cliffanet/rwled/hw/ctrl/rwled-ctrl-v0.1.png

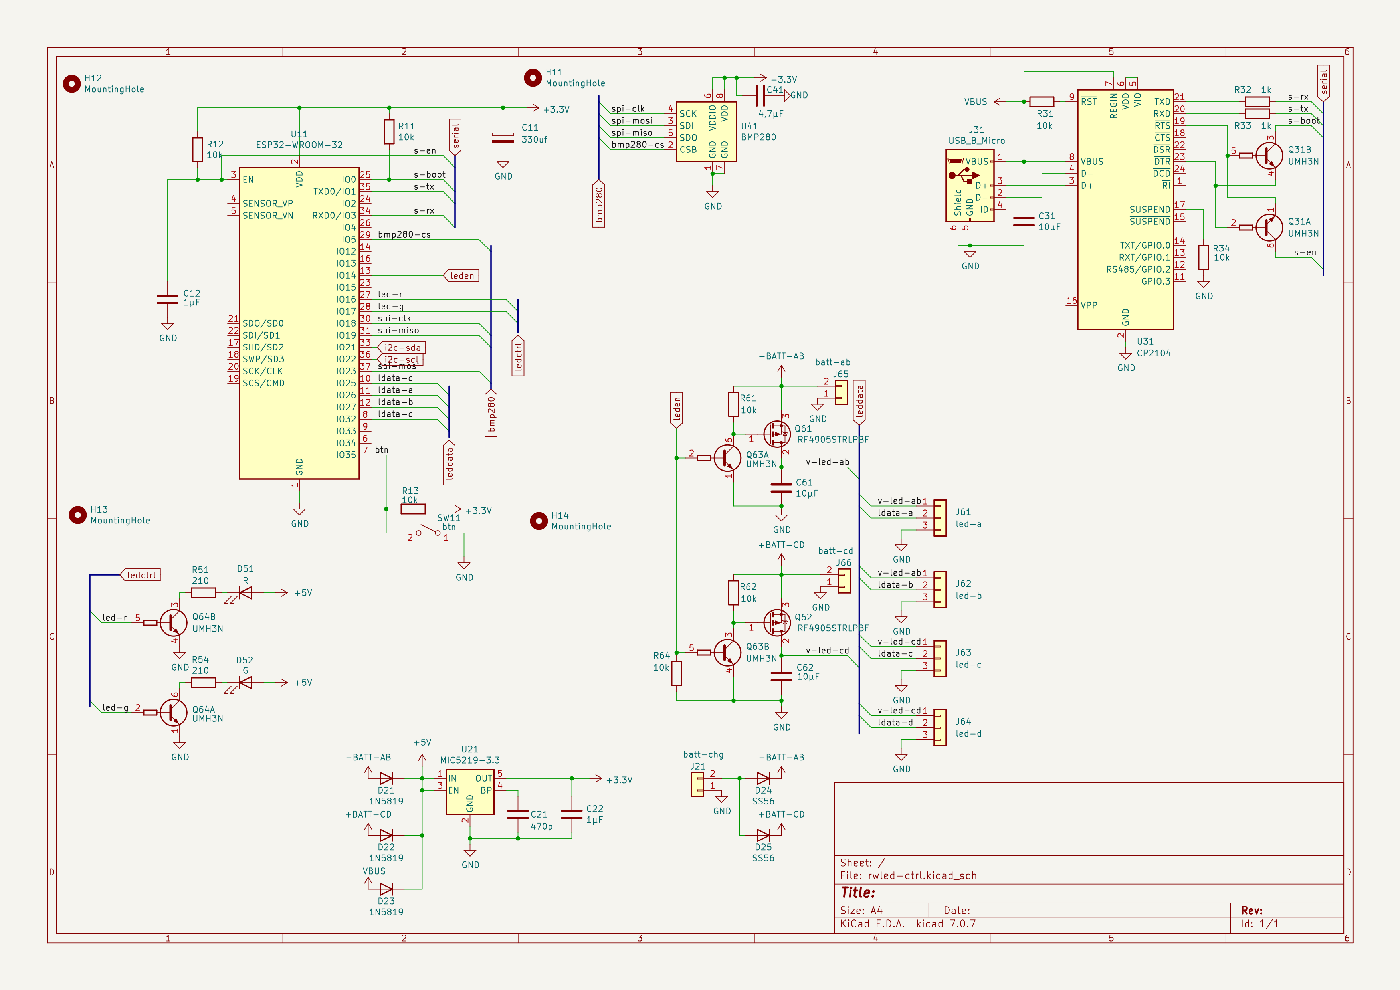
hw/ctrl/rwled-ctrl-v0.1.png
