cliffanet/rwled/hw/ctrl/rwled-ctrl-v0.2.png

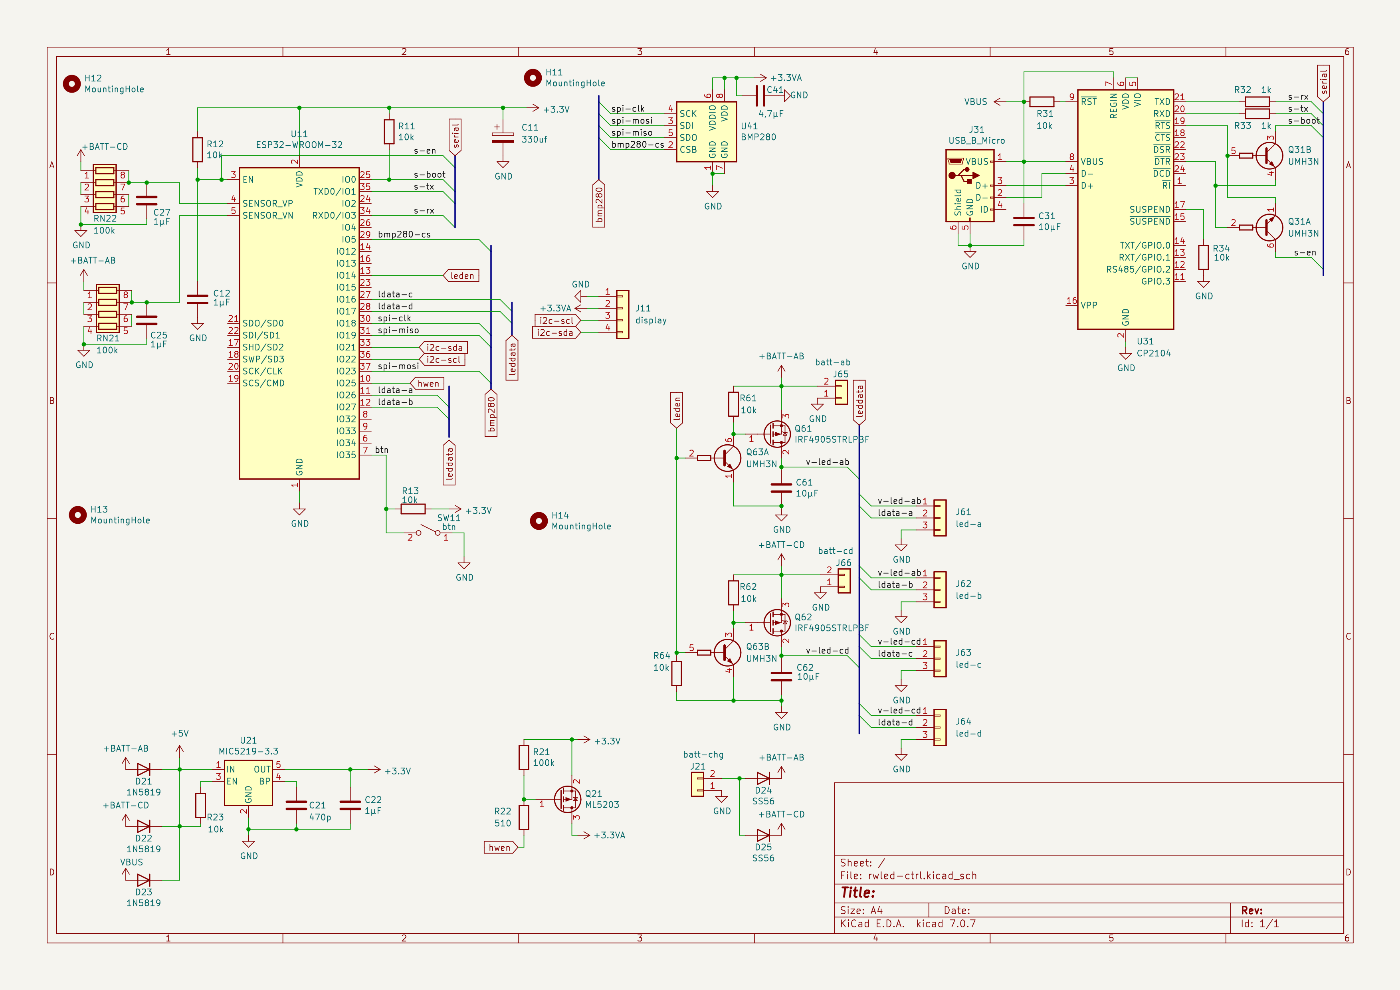
hw/ctrl/rwled-ctrl-v0.2.png
