cliffanet/rwled/hw/ledpanel-al10/v0.2/ledpanel-al10-v0.1.png

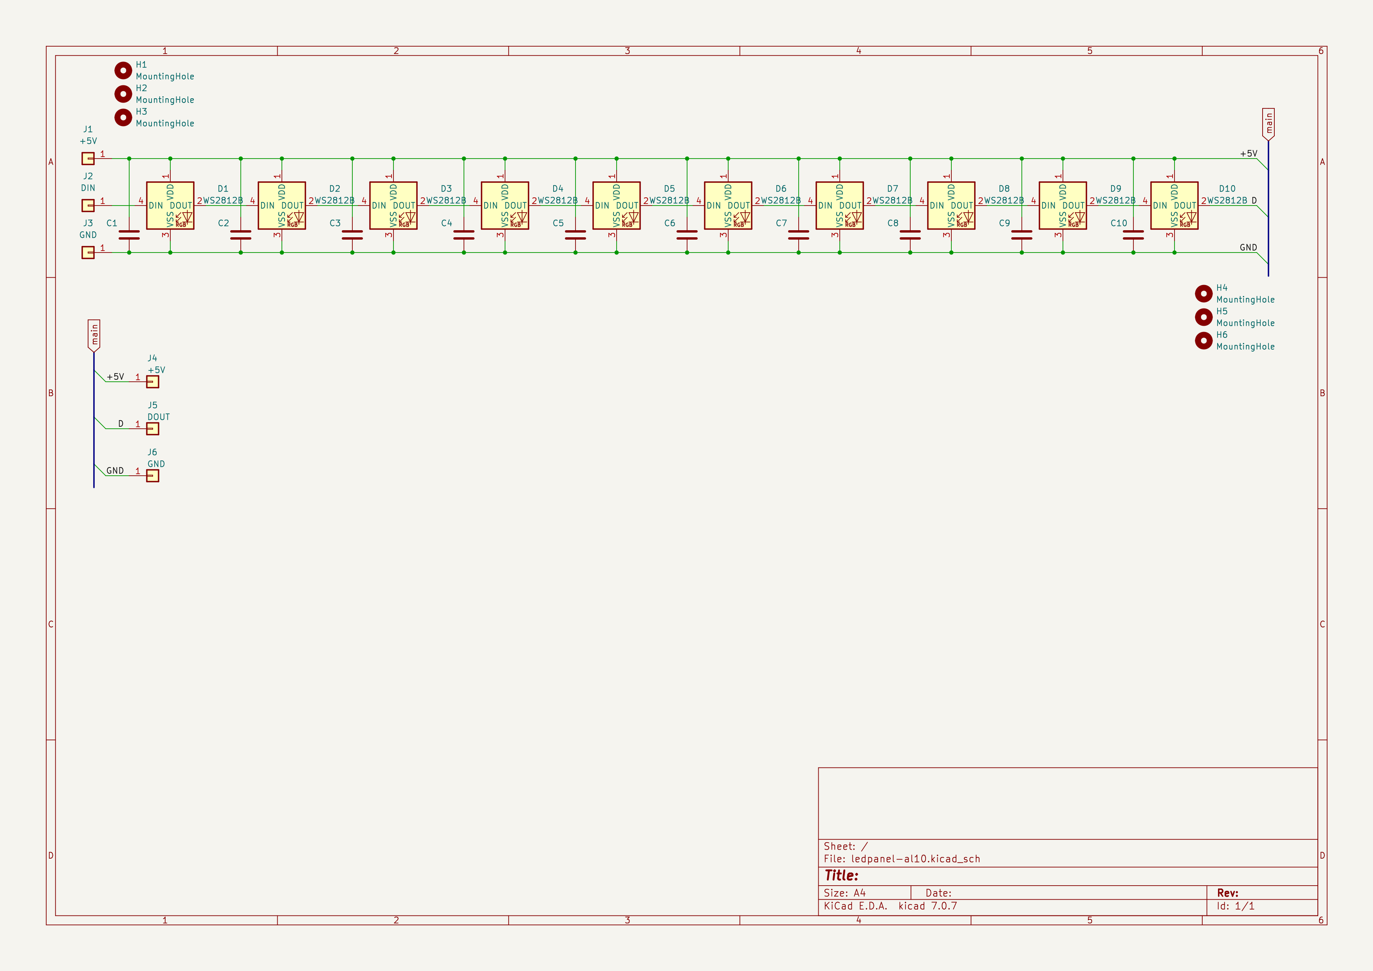
hw/ledpanel-al10/v0.2/ledpanel-al10-v0.1.png
