cliffanet/rwled/hw/ledpanel-al20/v0.2/ledpanel-al20-v0.1.png

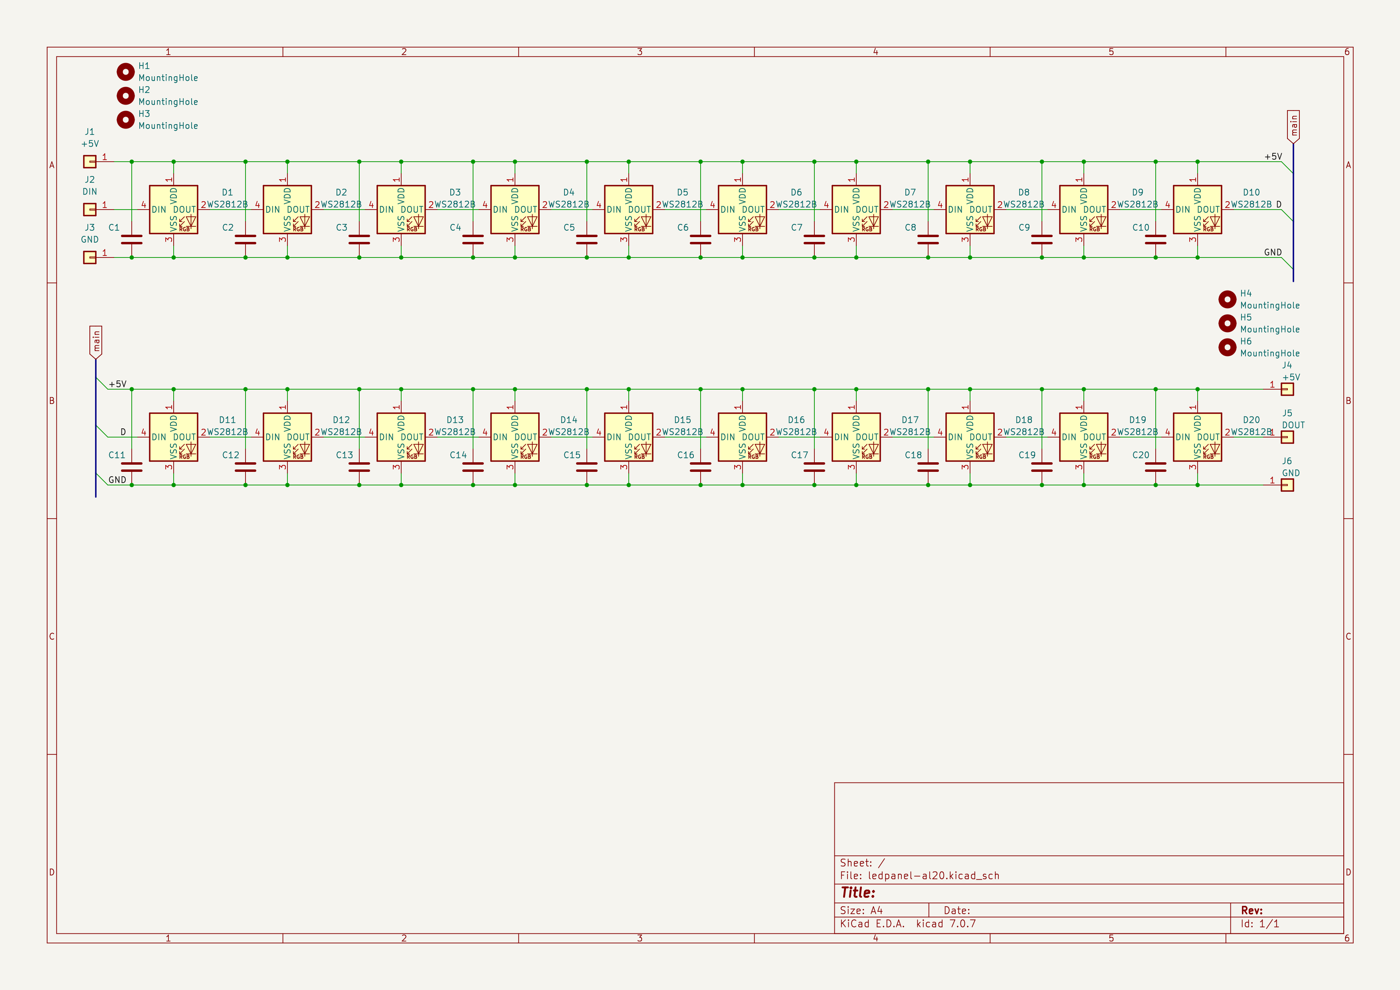
hw/ledpanel-al20/v0.2/ledpanel-al20-v0.1.png
