cliffanet/rwled/box/rwled.FCStd

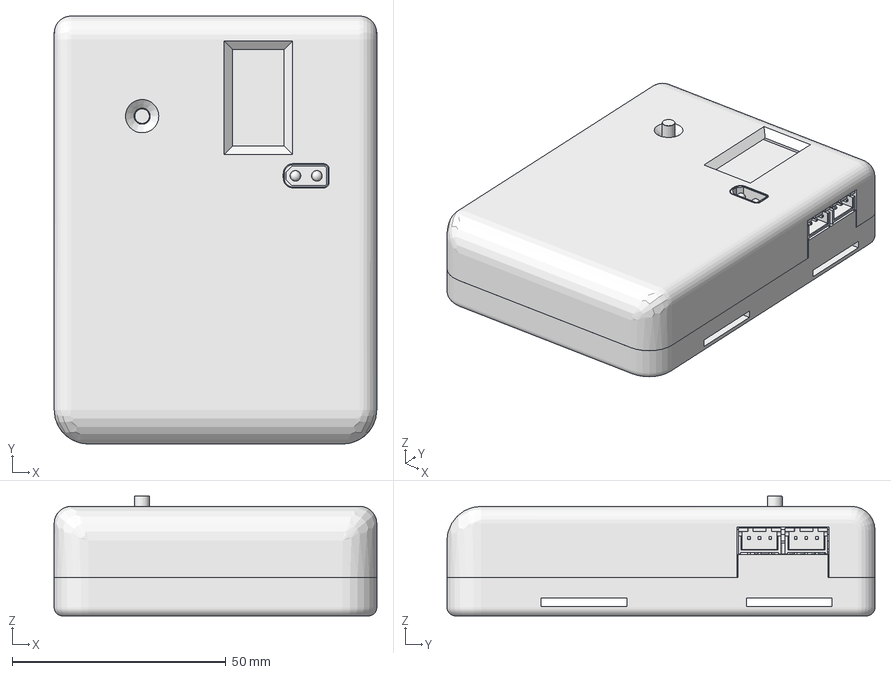
[picture p5: CAD file, 2024-09-29]
box/rwled.FCStd
75.4 x 100.0 x 28.0 mm
up
Micro USB-B Female 5Pin SMD
Micro USB-B Female 5Pin SMD001
Micro USB-B Female 5Pin SMD002
Micro USB-B Female 5Pin SMD003
Micro USB-B Female 5Pin SMD004
Micro USB-B Female 5Pin SMD005
Micro USB-B Female 5Pin SMD006
SW_PUSH_6mm_h13mm
accum-a
accum-b
Circle
rwled-ctrl PCB
display
down
XT30F
