cliffanet/rwled/box/rwled-down.stl

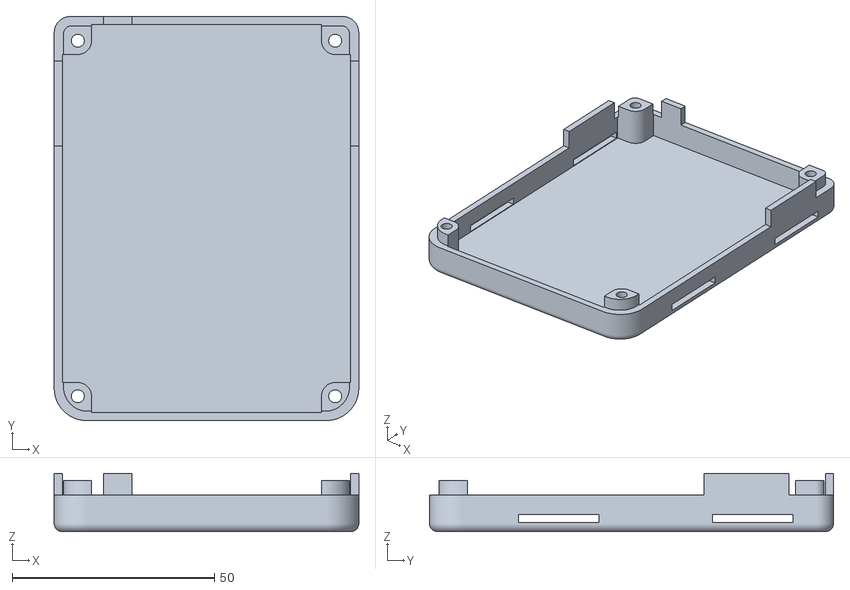
[picture p7: CAD file, 2024-09-29]
box/rwled-down.stl
75.4 x 100.0 x 14.4
