cliffanet/rwled/box/v0.1/rwled-up.stl

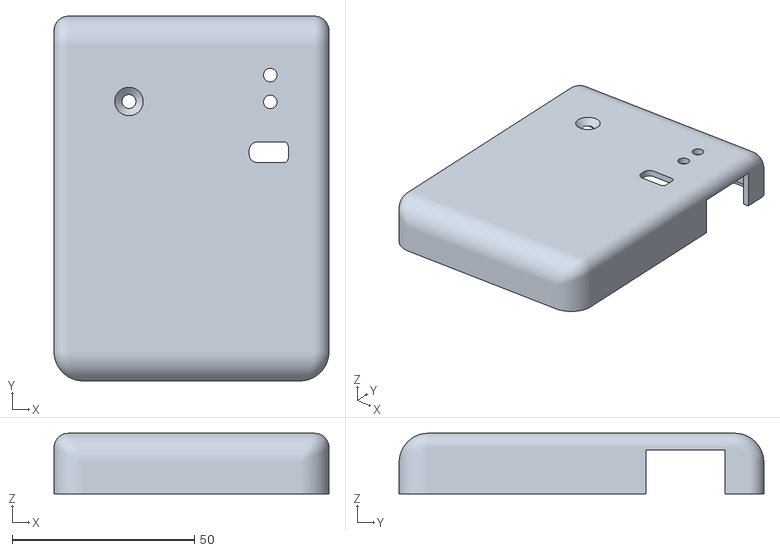
[picture p8: CAD file, 2024-01-13]
box/v0.1/rwled-up.stl
75.4 x 100.0 x 16.6
