cliffanet/rwled/box/charger-up.stl

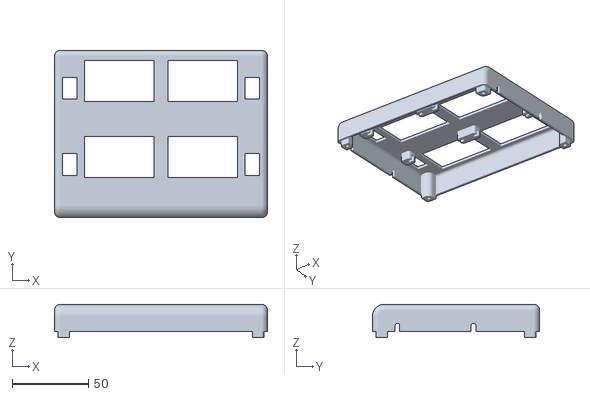
[picture p9: CAD file, 2024-06-04]
box/charger-up.stl
140.0 x 110.0 x 22.0
