cliffanet/rwled/box/charger-down.stl

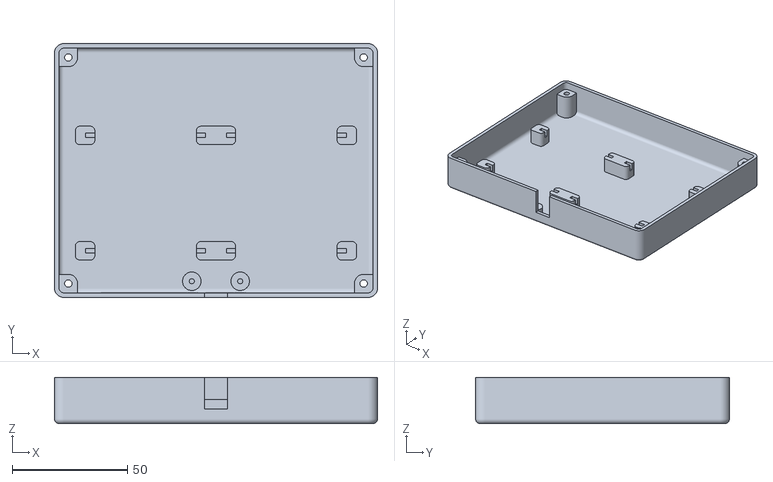
[picture p10: CAD file, 2024-06-04]
box/charger-down.stl
140.0 x 110.0 x 20.0
