cliffanet/rwled/box/rwled-up.stl

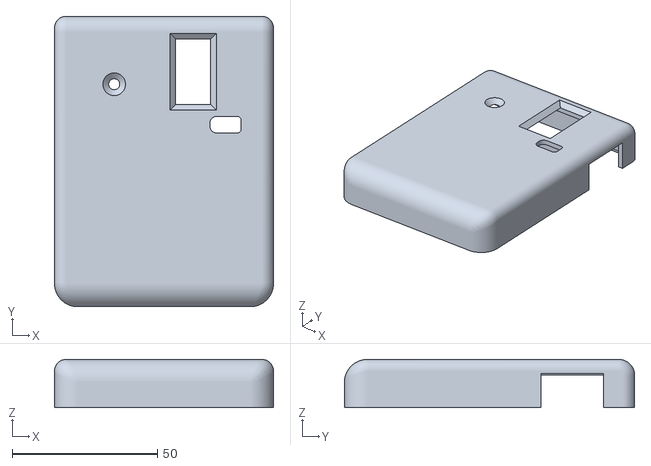
[picture p11: CAD file, 2024-06-04]
box/rwled-up.stl
75.4 x 100.0 x 16.6
