cliffanet/rwled/(list of files, cad)

Other CAD files:
box/v0.1/rwled-down.stl
