cliffanet/rwled/hw/ctrl/v0.1/rwled-ctrl.kicad_pcb

## KiCad design hw/ctrl/v0.1/rwled-ctrl.kicad_pcb (2024-04-06, an earlier design)

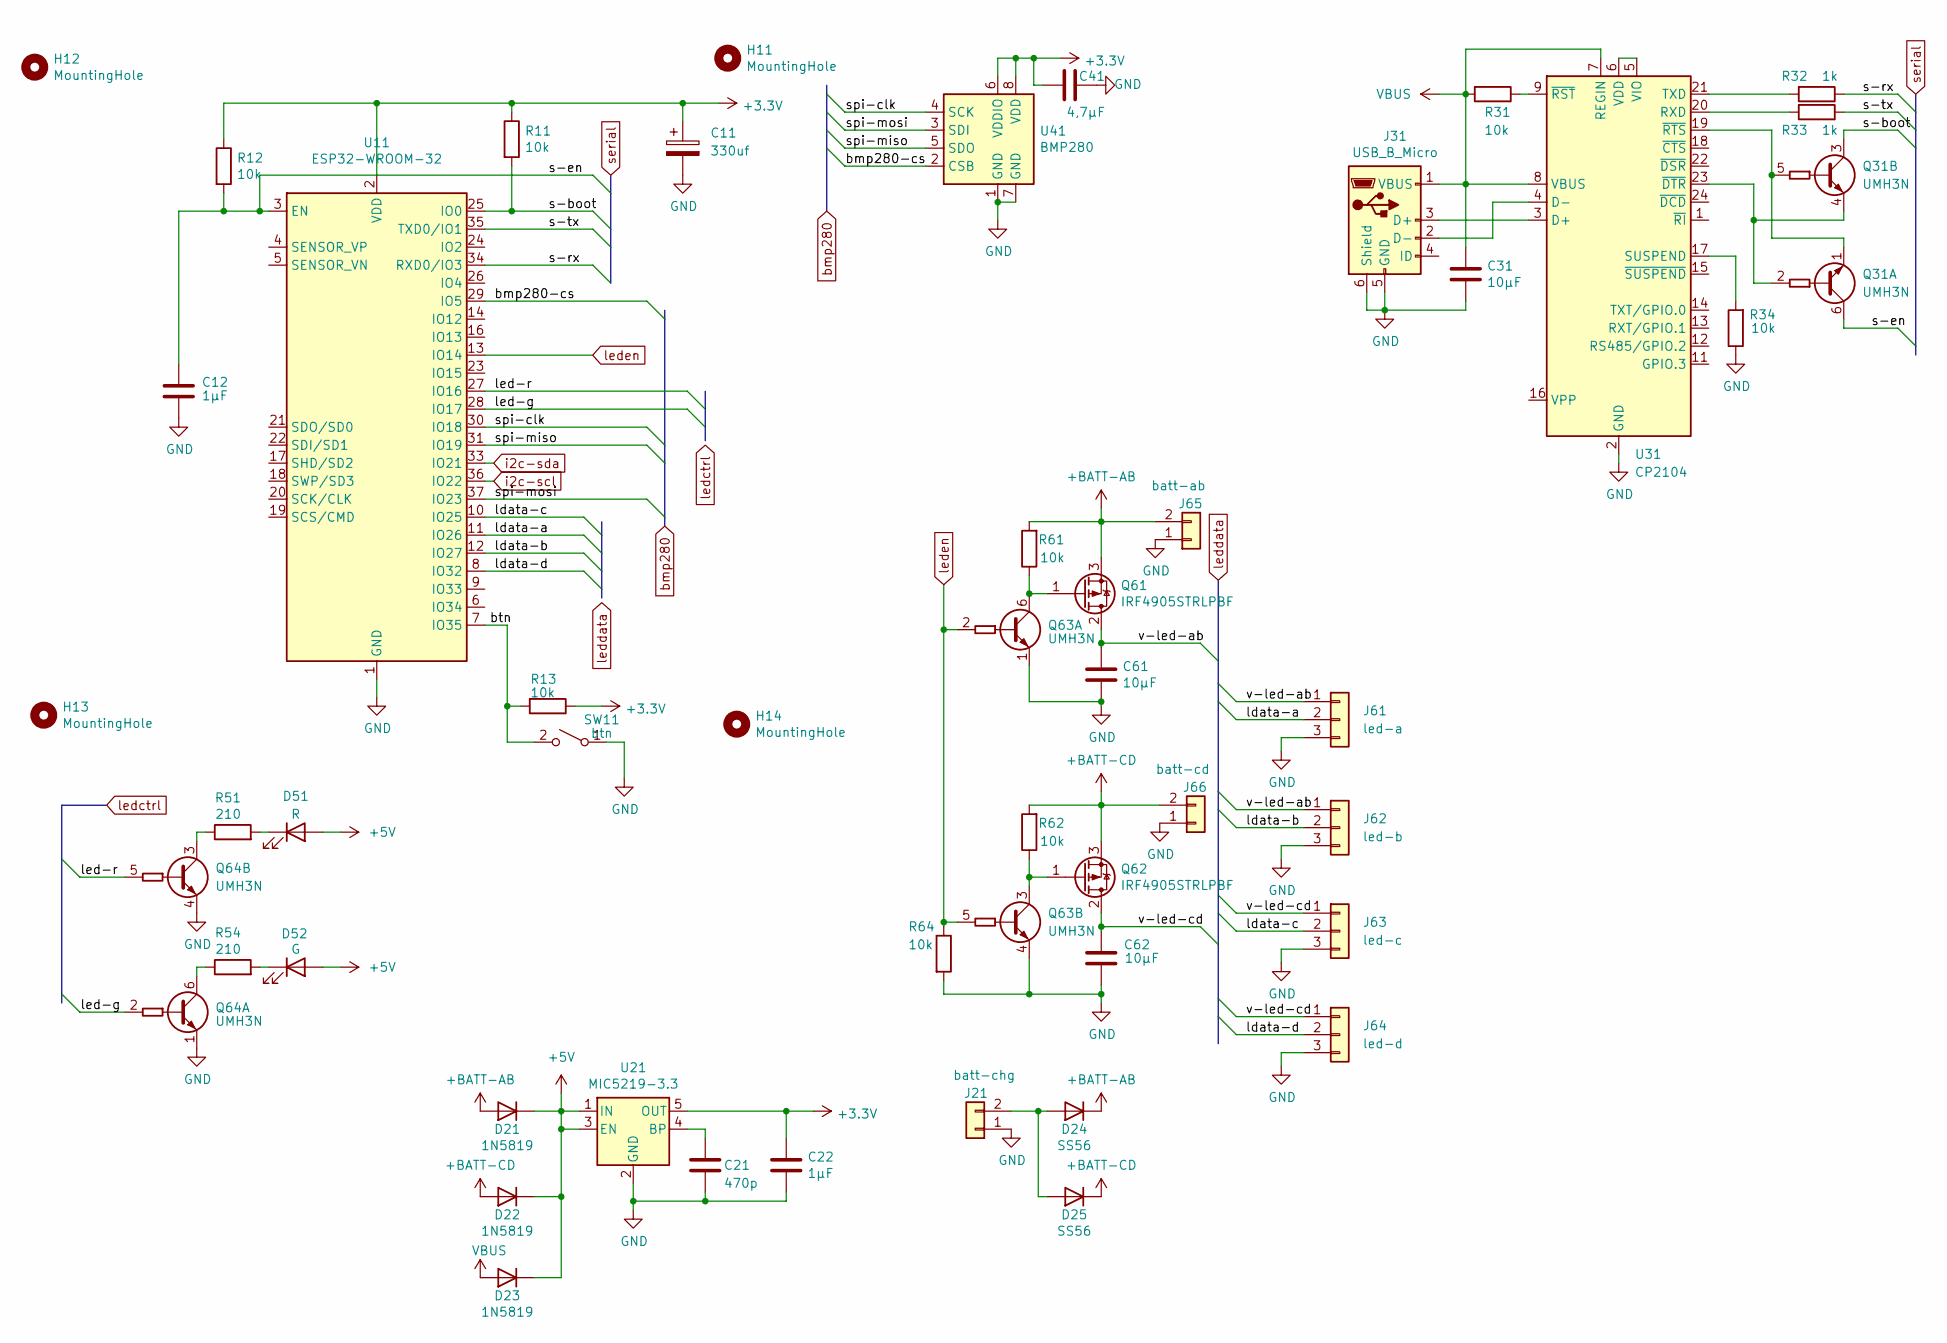
[picture p12: schematic rwled-ctrl.kicad_sch]

Parts:
C11: 330uf; CP_EIA-7343-20_Kemet-V
C12, C22: 1μF; C_0805_2012Metric
C21: 470p; C_0805_2012Metric
C31, C61, C62: 10μF; C_0805_2012Metric
C41: 4,7μF; C_0805_2012Metric
D21, D22, D23: 1N5819; D_SOD-323
D24, D25: SS56; D_SMA
D51: R; LED_D3.0mm
D52: G; LED_D3.0mm
H11, H12, H13, H14: MountingHole; MountingHole_3.2mm_M3
J21: batt-chg; AMASS_XT30U-M_1x02_P5.0mm_Vertical
J31: USB_B_Micro; USB_Micro-B_Molex-105017-0001
J61: led-a; JST_XH_S3B-XH-A_1x03_P2.50mm_Horizontal
J62: led-b; JST_XH_S3B-XH-A_1x03_P2.50mm_Horizontal
J63: led-c; JST_XH_S3B-XH-A_1x03_P2.50mm_Horizontal
J64: led-d; JST_XH_S3B-XH-A_1x03_P2.50mm_Horizontal
J65: batt-ab; AMASS_XT30U-F_1x02_P5.0mm_Vertical
J66: batt-cd; AMASS_XT30U-F_1x02_P5.0mm_Vertical
Q31, Q63, Q64: UMH3N; SOT-363_SC-70-6
Q61, Q62: IRF4905STRLPBF; TO-263-2
R11, R12, R13, R31, R34, R61, R62, R64: 10k; R_0805_2012Metric
R32, R33: 1k; R_0805_2012Metric
R51, R54: 210; R_1206_3216Metric
SW11: btn; SW_Push_1P1T_NO_6x6mm_H9.5mm
U11: ESP32-WROOM-32
U21: MIC5219-3.3; SOT-23-5
U31: CP2104; QFN-24-1EP_4x4mm_P0.5mm_EP2.6x2.6mm
U41: BMP280; Bosch_LGA-8_2x2.5mm_P0.65mm_ClockwisePinNumbering

Connections:
+3.3V: C11.1, C22.1, C41.1, R11.1, R12.1, R13.1, U11.2 (VDD), U21.5 (OUT), U41.6 (VDDIO), U41.8 (VDD)
+5V: D21.1 (K), D22.1 (K), D23.1 (K), D51.2 (A), D52.2 (A), U21.1 (IN), U21.3 (EN)
+BATT-AB: D21.2 (A), D24.1 (K), J65.2, Q61.3 (S), R61.2
+BATT-CD: D22.2 (A), D25.1 (K), J66.2, Q62.3 (S), R62.2
/bmp280-cs: U11.29 (IO5), U41.2 (CSB)
/btn: R13.2, SW11.2 (B), U11.7 (IO35)
/ldata-a: J61.2, U11.11 (IO26)
/ldata-b: J62.2, U11.12 (IO27)
/ldata-c: J63.2, U11.10 (IO25)
/ldata-d: J64.2, U11.8 (IO32)
/led-g: Q64.2 (B1), U11.28 (IO17)
/led-r: Q64.5 (B2), U11.27 (IO16)
/s-boot: Q31.3 (C2), R11.2, U11.25 (IO0)
/s-en: C12.1, Q31.6 (C1), R12.2, U11.3 (EN)
/s-rx: R32.1, U11.34 (RXD0/IO3)
/s-tx: R33.1, U11.35 (TXD0/IO1)
/spi-clk: U11.30 (IO18), U41.4 (SCK)
/spi-miso: U11.31 (IO19), U41.5 (SDO)
/spi-mosi: U11.37 (IO23), U41.3 (SDI)
/v-led-ab: C61.1, J61.1, J62.1, Q61.2 (D)
/v-led-cd: C62.2, J63.1, J64.1, Q62.2 (D)
GND: C11.2, C12.2, C21.2, C22.2, C31.2, C41.2, C61.2, C62.1, J21.1, J31.5 (GND), J31.6 (Shield), J61.3, J62.3, J63.3, J64.3, J65.1, J66.1, Q63.1 (E1), Q63.4 (E2), Q64.1 (E1), Q64.4 (E2), R34.1, R64.2, SW11.1 (A), U11.1 (GND), U11.15 (GND), U11.38 (GND), U11.39 (GND), U21.2 (GND), U31.2 (GND), U31.25 (GND), U41.1 (GND), U41.7 (GND)
unnamed: D24.2 (A), D25.2 (A), J21.2
unnamed: D51.1 (K), R51.2
unnamed: D52.1 (K), R54.2
unnamed: J31.3 (D+), U31.3 (D+)
unnamed: J31.2 (D-), U31.4 (D-)
unnamed: Q31.2 (B1), Q31.4 (E2), U31.23 (~DTR)
unnamed: Q31.1 (E1), Q31.5 (B2), U31.19 (~RTS)
unnamed: Q61.1 (G), Q63.6 (C1), R61.1
unnamed: Q62.1 (G), Q63.3 (C2), R62.1
unnamed: Q64.6 (C1), R54.1
unnamed: Q64.3 (C2), R51.1
unnamed: C21.1, U21.4 (BP)
unnamed: R33.2, U31.20 (RXD)
unnamed: R34.2, U31.17 (SUSPEND)
unnamed: R32.2, U31.21 (TXD)
unnamed: U31.5 (VIO), U31.6 (VDD)
unnamed: R31.1, U31.9 (~RST)
VBUS: C31.1, D23.2 (A), J31.1 (VBUS), R31.2, U31.7 (REGIN), U31.8 (VBUS)
i2c-scl: U11.36 (IO22)
i2c-sda: U11.33 (IO21)
leden: Q63.2 (B1), Q63.5 (B2), R64.1, U11.13 (IO14)

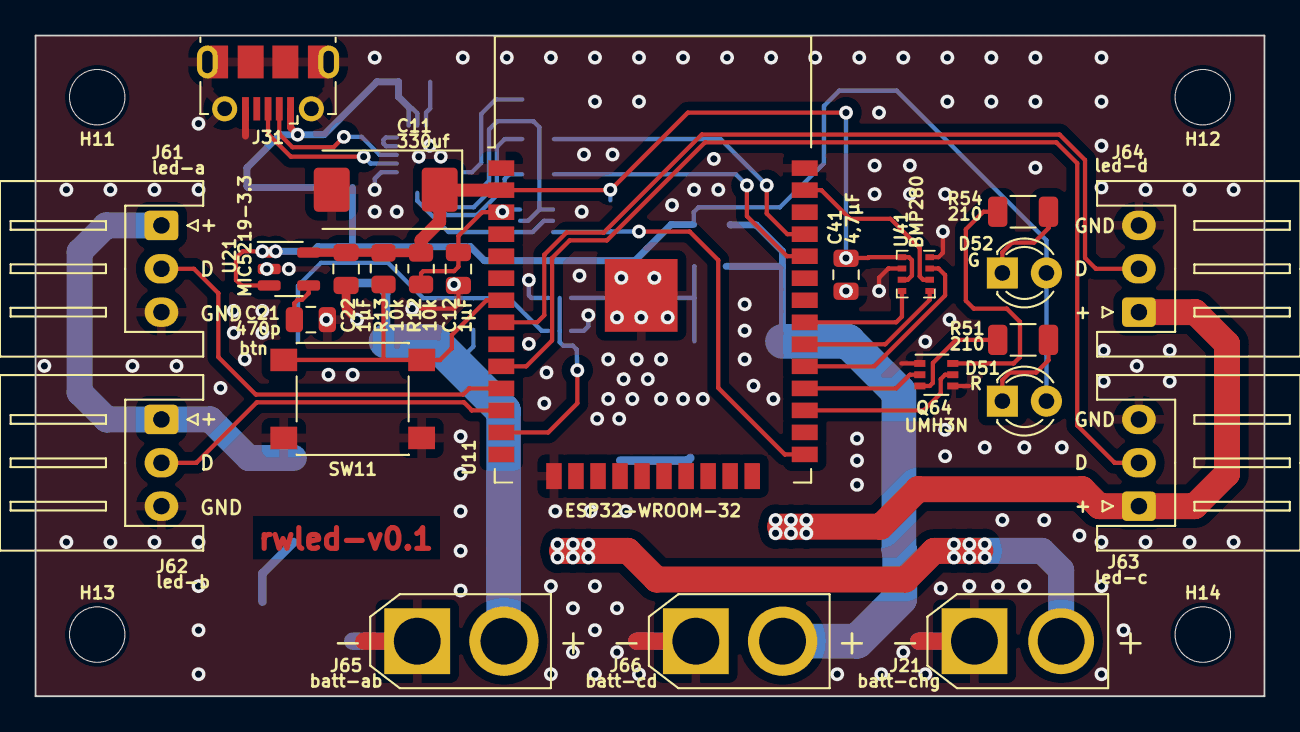
[picture p13: board rwled-ctrl.kicad_pcb from above]

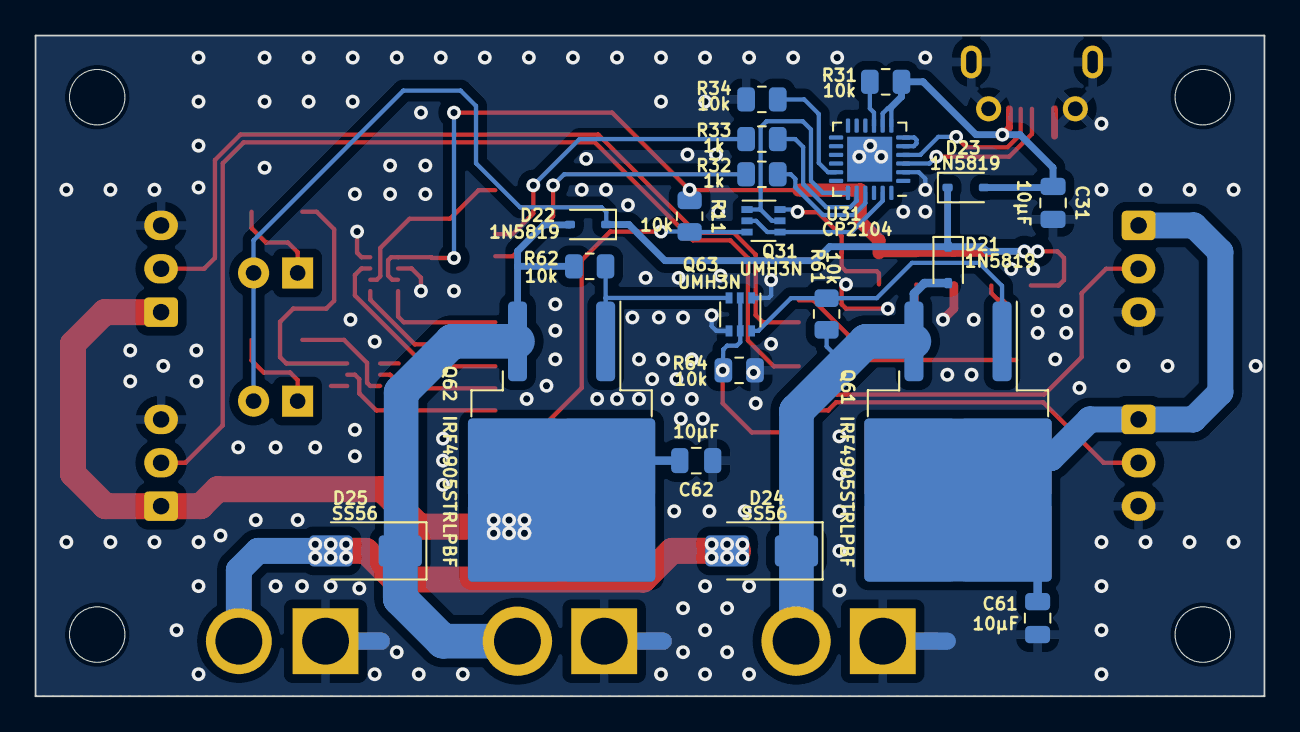
[picture p14: board rwled-ctrl.kicad_pcb from below]

Board: 2 copper layers, 70.9 x 38.1 mm, 49 parts (21 on the bottom side), 41 nets.
