cliffanet/rwled/hw/ledpanel-al10/v0.2/ledpanel-al10.kicad_pcb

## KiCad design hw/ledpanel-al10/v0.2/ledpanel-al10.kicad_pcb (2024-02-18)

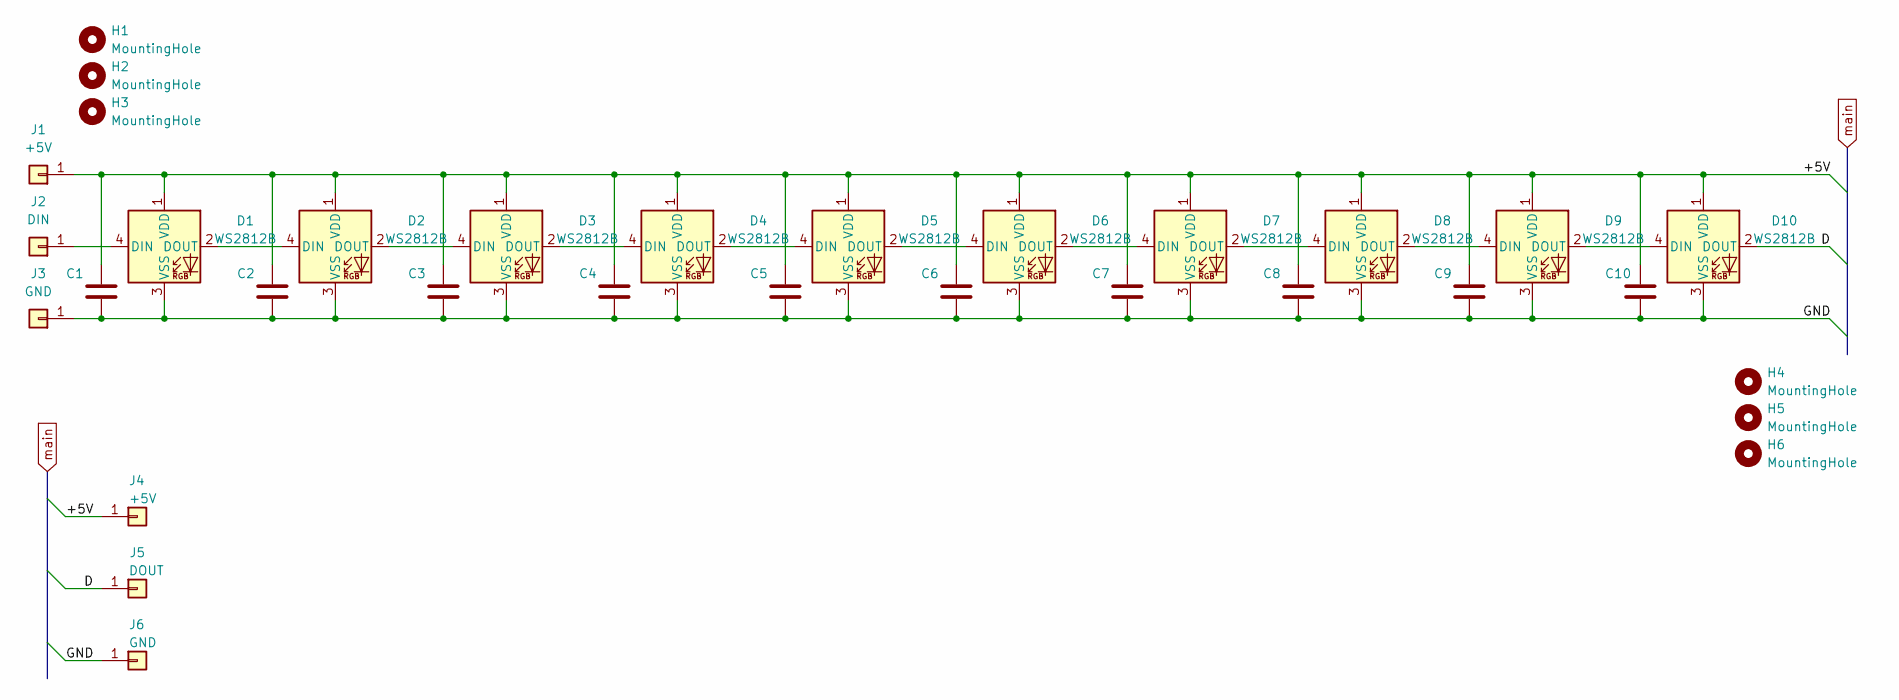
[picture p15: schematic ledpanel-al10.kicad_sch]

Parts:
C1, C2, C3, C4, C5, C6, C7, C8, C9, C10: C; C_0805_2012Metric
D1, D2, D3, D4, D5, D6, D7, D8, D9, D10: WS2812B; LED_WS2812B_PLCC4_5.0x5.0mm_P3.2mm
H1, H2, H3, H4, H5, H6: MountingHole; MountingHole_2.1mm
J1, J4: +5V; SolderWirePad_1x01_SMD_1x2mm
J2: DIN; SolderWirePad_1x01_SMD_1x2mm
J3, J6: GND; SolderWirePad_1x01_SMD_1x2mm
J5: DOUT; SolderWirePad_1x01_SMD_1x2mm

Connections:
/+5V: C1.1, C2.1, C3.1, C4.1, C5.1, C6.1, C7.1, C8.1, C9.1, C10.1, D1.1 (VDD), D2.1 (VDD), D3.1 (VDD), D4.1 (VDD), D5.1 (VDD), D6.1 (VDD), D7.1 (VDD), D8.1 (VDD), D9.1 (VDD), D10.1 (VDD), J1.1, J4.1
/D: D10.2 (DOUT), J5.1
/GND: C1.2, C2.2, C3.2, C4.2, C5.2, C6.2, C7.2, C8.2, C9.2, C10.2, D1.3 (VSS), D2.3 (VSS), D3.3 (VSS), D4.3 (VSS), D5.3 (VSS), D6.3 (VSS), D7.3 (VSS), D8.3 (VSS), D9.3 (VSS), D10.3 (VSS), J3.1, J6.1
unnamed: D1.4 (DIN), J2.1
unnamed: D1.2 (DOUT), D2.4 (DIN)
unnamed: D2.2 (DOUT), D3.4 (DIN)
unnamed: D3.2 (DOUT), D4.4 (DIN)
unnamed: D4.2 (DOUT), D5.4 (DIN)
unnamed: D5.2 (DOUT), D6.4 (DIN)
unnamed: D6.2 (DOUT), D7.4 (DIN)
unnamed: D7.2 (DOUT), D8.4 (DIN)
unnamed: D8.2 (DOUT), D9.4 (DIN)
unnamed: D9.2 (DOUT), D10.4 (DIN)

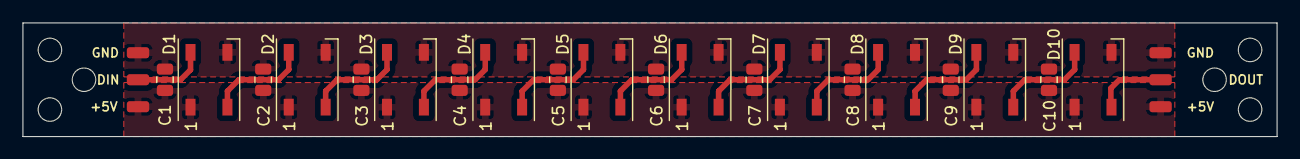
[picture p16: board ledpanel-al10.kicad_pcb from above]

Board: 2 copper layers, 112.1 x 10.2 mm, 32 parts (0 on the bottom side), 13 nets.
