cliffanet/rwled/src/wifiserver.cpp

/*
    WiFi-server functions
*/

#include "wifiserver.h"
#include "core/worker.h"
#include "core/btn.h"
#include "core/display.h"
#include "core/indicator.h"
#include "core/file.h"
#include "core/clock.h"
#include "core/log.h"
#include "jump.h"
#include "led/read.h"
#include "led/save.h"
#include "led/work.h"

#include <esp_err.h>
#include <esp_wifi.h>

#include <DNSServer.h>
#include <WebServer.h>

void pwrmain();

/* ------------------------------------------------------------------------------------------- *
 *  netif
 *  из-за того, что esp_netif_deinit не поддерживается,
 *  мы можем сделать esp_netif_init только один раз
 * ------------------------------------------------------------------------------------------- */
bool wifiNetIfInit() {
    static bool _init = false;
    if (_init)
        return true;
    
#if CONFIG_IDF_TARGET_ESP32
        uint8_t mac[8];
        if (esp_efuse_mac_get_default(mac) == ESP_OK)
            esp_base_mac_addr_set(mac);
#endif
        
    ESPDO(esp_netif_init(), return false);
    _init = true;
    return true;
}

/* ------------------------------------------------------------------------------------------- *
 *  Запуск / остановка
 * ------------------------------------------------------------------------------------------- */
static esp_netif_t *_netif = NULL;
static bool event_loop = false;

static bool _init() {
#define ESP(func)   ESPDO(func, return false)

    // event loop
    if (!event_loop) {
        ESP(esp_event_loop_create_default());
        event_loop = true;
    }

    // netif
    if (!wifiNetIfInit())
        return false;
    
    if (_netif == NULL) {
        CONSOLE("esp_netif_create_default_wifi_ap");
        _netif = esp_netif_create_default_wifi_ap();
        if (_netif == NULL) {
            CONSOLE("esp_netif_create_default_wifi_ap fail");
            return false;
        }
        
        /*
        esp_netif_dhcp_status_t status = ESP_NETIF_DHCP_INIT;
        */
        esp_netif_ip_info_t info = { 0 };
        IP4_ADDR(&info.ip, 192, 168, 4, 22);
        info.gw = info.ip;
        IP4_ADDR(&info.netmask, 255, 255, 255, 0);

        ESP(esp_netif_dhcps_stop(_netif));
        ESP(esp_netif_set_ip_info(_netif, &info));
        auto mask = info.netmask.addr;
        ESP(esp_netif_dhcps_option(_netif, ESP_NETIF_OP_SET, ESP_NETIF_SUBNET_MASK, (void*)&mask, sizeof(mask)));
        dhcps_lease_t lease = { 0 };
        lease.enable = true;
        IP4_ADDR(&lease.start_ip, 192, 168, 4, 101);
        IP4_ADDR(&lease.end_ip, 192, 168, 4, 111);
        ESP(esp_netif_dhcps_option(_netif, ESP_NETIF_OP_SET, ESP_NETIF_REQUESTED_IP_ADDRESS, (void*)&lease, sizeof(lease)));
        ESP(esp_netif_dhcps_start(_netif));
    }
    
    // init
    wifi_init_config_t init_cfg = WIFI_INIT_CONFIG_DEFAULT();
    ESP(esp_wifi_init(&init_cfg));
    ESP(esp_wifi_set_storage(WIFI_STORAGE_RAM));
    
    // mode
    ESP(esp_wifi_set_mode(WIFI_MODE_AP));

    // config
    wifi_config_t cfg = { 0 };
    cfg.ap.channel          = 6;
    cfg.ap.max_connection   = 4;
    cfg.ap.beacon_interval  = 100;
    cfg.ap.authmode         = WIFI_AUTH_OPEN;

    cfg.ap.ssid_len =
        LedRead::opened() ?
            snprintf_P(
                reinterpret_cast<char*>(cfg.ap.ssid),
                sizeof(cfg.ap.ssid),
                PSTR("rwled-n%02d"), LedRead::mynum()
            ) :
            snprintf_P(
                reinterpret_cast<char*>(cfg.ap.ssid),
                sizeof(cfg.ap.ssid),
                PSTR("rwled-empty")
            );
    ESP(esp_wifi_set_config(WIFI_IF_AP, &cfg));

    // start
    ESP(esp_wifi_start());
    //ESP(esp_wifi_set_max_tx_power(60));
    
    CONSOLE("wifi started");

#undef ESP
    
    return true;
}

static bool _stop() {
    bool ret = true;
#define ESP(func)   ESPDO(func, ret = false)
    
    ESP(esp_wifi_stop());
    ESP(esp_wifi_deinit());
    
    if (_netif != NULL) {
        ESP(esp_netif_dhcps_stop(_netif));
        esp_netif_destroy_default_wifi(_netif);
        _netif = NULL;
    }
    
    // Из описания: Note: Deinitialization is not supported yet
    // ESP(esp_netif_deinit());

    ESP(esp_event_loop_delete_default());
    event_loop = false;
    
    CONSOLE("wifi stopped: %d", ret);
    
#undef ESP
    
    return ret;
}

void _reset();

/* ------------------------------------------------------------------------------------------- *
 *  webserver
 * ------------------------------------------------------------------------------------------- */
const char html_ok[] PROGMEM = R"rawliteral(
<p>Uploaded</p>
)rawliteral";

const char html_index[] PROGMEM = R"rawliteral(
<!DOCTYPE HTML>
<html lang="en">
<head>
  <meta name="viewport" content="width=device-width, initial-scale=1">
  <meta charset="UTF-8">
</head>
<body>
  <p><h1>LED Upload</h1></p>
  <form method="POST" enctype="multipart/form-data" id="formup">
    <input type="file" name="data" id="data" onchange="uploadFile()"/>
    <br />
    <progress id="prog" value="0" max="100" style="width:100%%;"></progress>
    <h3 id="status"></h3>
    <br />
    <p>exist file: %d b</p>
    <p>SPIFFS used: %d b</p>
    <p>SPIFFS full: %d b</p>
  </form>
  <input type="checkbox" id="fmtchk" />
  <button id="fmtbtn" onclick="format()">Format SPIFFS</button>
  <script>
    function _(el) {
      return document.getElementById(el);
    }
    function h(el, html) {
      _(el).innerHTML = html;
    }
    function uploadFile() {
      var file = _("data").files[0];
      var f = new FormData();
      f.append("data", file);
      _("data").disabled = true;
      _("fmtbtn").disabled = true;
      var ajax = new XMLHttpRequest();
      ajax.upload.addEventListener("progress", prog, false);
      ajax.addEventListener("load", cmpl, false);
      ajax.addEventListener("error", err, false);
      ajax.addEventListener("abort", abrt, false);
      ajax.open("POST", "/upload");
      ajax.send(f);
    }
    function prog(e) {
      var p = Math.round((e.loaded / e.total) * 100);
      _("prog").value = p;
      h("status", p + "%% ("+e.loaded+" of "+e.total+" b)");
      _("data").disabled = false;
    }
    function format() {
      if (!_("fmtchk").checked)
        return false;
      _("data").disabled = true;
      _("fmtbtn").disabled = true;
      var ajax = new XMLHttpRequest();
      ajax.addEventListener("load", cmpl, false);
      ajax.addEventListener("error", err, false);
      ajax.addEventListener("abort", abrt, false);
      ajax.open("GET", "/fmt", true);
      ajax.send();
    }
    function cmpl(e) {
      h("status", e.target.responseText?"OK: "+e.target.responseText:"OK");
      _("data").disabled = false;
      _("fmtbtn").disabled = false;
    }
    function err(e) {
      h("status", "FAIL");
      _("data").disabled = false;
      _("fmtbtn").disabled = false;
    }
    function abrt(e) {
      h("status", "Aborted");
      _("data").disabled = false;
      _("fmtbtn").disabled = false;
    }
  </script>
</body>
</html>
)rawliteral";

/* ------------------------------------------------------------------------------------------- *
 *  процессинг
 * ------------------------------------------------------------------------------------------- */
class _wsrvWrk : public Wrk {
    const Btn _b = Btn([](){ wifiSrvStop(); });
#if HWVER < 2
    const Indicator _ind = Indicator(
        [this](uint16_t t) { return t < LedRead::mynum() * 5 + 20; },
        [this](uint16_t t) { return (t >= 10) && (t < LedRead::mynum() * 5 + 10) & (t % 5 < 2); },
        ((static_cast<uint16_t>(LedRead::mynum())+1) / 2 + 5) * 1000
    );
#endif

    Display _dspl = Display(
        [this](U8G2 &u8g2) {
            char s[30];

            u8g2.setFont(u8g2_font_ImpactBits_tr);
            SCPY("WiFi-server");
            u8g2.drawStr(SCENT, 30, s);

            wifi_config_t cfg;
            if (esp_wifi_get_config(WIFI_IF_AP, &cfg) == ESP_OK) {
                SPRN("ssid: %s", cfg.ap.ssid);
                u8g2.drawStr(0, 48, s);
            }

            wifi_sta_list_t cli;
            if (_upsz > 0) {
                SPRN("save: %d %% (%0.1f k)", _upcur * 100 / _upsz, static_cast<float>(_upcur) / 1024);
                u8g2.drawStr(0, 62, s);
            }
            else
            if (_upcur > 0) {
                SPRN("save: %0.1f k", static_cast<float>(_upcur) / 1024);
                u8g2.drawStr(0, 62, s);
            }
            else
            if ((esp_wifi_ap_get_sta_list(&cli) == ESP_OK) && (cli.num > 0)) {
                if (cli.num > 1)
                    SPRN("conn many: %d !!!", cli.num);
                else
                    SPRN("conn rssi: %d dB", cli.sta[0].rssi);
                u8g2.drawStr(0, 62, s);
            }
            else {
                int32_t ts = _to < 2000 ? (2000 - _to)*30 / 1000 : 0;
                SPRN("%d:%02d", ts / 60, ts % 60);
                u8g2.drawStr(40-SWIDTH, 62, s);
            }
        }
    );

    DNSServer dns;
    WebServer web;
    LedSaverBuf _prs;
    bool fin = false;
    uint32_t _to = 1;
    uint32_t _upsz = 0, _upcur = 0;
    int64_t _ddraw = 0;

    void close() {
        fin = true;
        web.client().stop();
        web.client().flush();
        web.close();
    }

    void upload_reply() {
        web.sendHeader("Connection", "close");
    }
    void upload_data() {
        if (fin) return;
        HTTPUpload &upload = web.upload();
        switch (upload.status) {
            case UPLOAD_FILE_START:
                CONSOLE("Upload: (%d bytes) %s", upload.totalSize, upload.filename.c_str());
                if (_prs.open())
                    _to = 1;
                else
                    close();
                _upsz = upload.totalSize;
                _upcur = 0;
                break;
            case UPLOAD_FILE_WRITE:
                CONSOLE("read bytes: %d", upload.currentSize);
                {
                    auto ok = _prs.read(upload.currentSize, [this, upload](char *buf, size_t sz) {
                        memcpy(buf, upload.buf, sz);
                        return sz;
                    });
                    if (!ok) close();
                }
                _to = 1;
                _upcur += upload.currentSize;
                break;
            case UPLOAD_FILE_END:
                CONSOLE("upload end");
                fin = true;
                web.send_P(200, "text/html", html_ok);
                _upsz = 0;
                _upcur = 0;
                break;
            case UPLOAD_FILE_ABORTED:
                CONSOLE("upload aborted");
                fin = true;
                _upsz = 0;
                _upcur = 0;
                break;
        }
            
        // При загрузке файла управление воркеру обратно не отдаётся
        // до самого завершения загрузки, поэтому надо вручную
        // перерисовывать дисплей
        auto tm = tmill();
        if (tm-_ddraw > 100) {
            _ddraw = tm;
            Display::redraw();
        }
    }
    void format() {
        char ctype[64];
        strncpy_P(ctype, PSTR("text/html"), sizeof(ctype));

        _to = 1;
        bool ok = fileFormat();
        web.send_P(200, ctype, ok ? PSTR("Formatted") : PSTR("format ERROR"));
    }
    void web_index() {
        char ctype[64];
        strncpy_P(ctype, PSTR("text/html"), sizeof(ctype));

        char s[strlen_P(html_index)+64];
        auto i = fileInfo();
        snprintf_P(s, sizeof(s), html_index, LedRead::fsize(), i.used, i.total);

        web.send(200, ctype, (String)s);
    }

public:
    _wsrvWrk() :
        web(80)
    {
  delay(100);
        esp_netif_ip_info_t info = { 0 };
        if ((_netif != NULL) && (esp_netif_get_ip_info(_netif, &info) == ESP_OK)) {
            auto ip = IPAddress(info.ip.addr);
            if (dns.start(53, "*", ip))
                CONSOLE("dns ok: %s", ip.toString().c_str());
            else
                CONSOLE("dns bind fail (%s)", ip.toString().c_str());
        }
        else
            CONSOLE("Can\'t get self-IP");

        web.on(
            "/upload", HTTP_POST,
            [this]() { upload_reply(); },
            [this]() { upload_data(); }
        );
        web.on("/fmt", HTTP_GET, [this]() { format(); });
        web.onNotFound([this]() { web_index(); });
        web.begin();
    }
    ~_wsrvWrk() {
        CONSOLE("(0x%08x) destroy", this);
    }

    state_t run() {
        dns.processNextRequest();
        web.handleClient();
        if (fin) return END;
        if (_to > 0) {
            _to ++;
            if (_to > 2000) {
                CONSOLE("upload timeout");
                return END;
            }
        }

        return DLY;
    }

    void end() {
        dns.stop();
        web.stop();
        _stop();
        _reset();

        pwrmain();
    }
};
static WrkProc<_wsrvWrk> _wifi;

void _reset() {
    _wifi.reset();
}

bool wifiSrvStart() {
    if (!_init()) {
        _stop();
        return false;
    }

    if (!_wifi.isrun())
        _wifi = wrkRun<_wsrvWrk>();
    
    return true;
}

bool wifiSrvStop() {
    if (!_wifi.isrun())
        return false;
    
    _wifi.term();

    return true;
}
