cliffanet/rwled/src/core/display.cpp

#include "display.h"
#include "worker.h"
#include "log.h"

#include <list>

/* ------------------------------------------------------------------------------------------- *
 *  Дисплей
 * ------------------------------------------------------------------------------------------- */

static U8G2_SSD1306_128X64_NONAME_1_HW_I2C u8g2(U8G2_R0);

class _dsplWrk : public Wrk {
    std::list<Display*> _hnd;
    uint8_t _cnt = 0;

public:
    _dsplWrk() {
        init();
    }
    ~_dsplWrk() {
        CONSOLE("(0x%08x) destroy", this);
    }

    void init() {
        CONSOLE("(0x%08x) init", this);
        u8g2.begin();
    }

    bool empty() const {
        return _hnd.empty();
    }

    void add(Display *d) {
        CONSOLE("[%d]: 0x%08x", _hnd.size(), d);
        _hnd.push_back(d);
    }
    bool del(Display *d) {
        CONSOLE("[%d]: 0x%08x", _hnd.size(), d);
        for (auto p = _hnd.begin(); p != _hnd.end(); p++)
            if (*p == d) {
                CONSOLE("found");
                _hnd.erase(p);
                return true;
            }

        return false;
    }

    void draw() {
        u8g2.firstPage();
        do {
            for (auto d = _hnd.rbegin(); d != _hnd.rend(); ++d) {
                (*d)->hnd(u8g2);
                if ((*d)->clr)
                    break;
            }
        }  while( u8g2.nextPage() );
    }

    state_t run() {
        if (_cnt < 4)
            _cnt++;
        else {
            _cnt = 0;
            draw();
        }
        // тут надо бы сделать распределённый во времени draw,
        // иначе единым куском получается очень долго (более 30ms),
        // что очень критично в условиях общего worker-interval=30ms

        return DLY;
    }
};

static WrkProc<_dsplWrk> _dspl;

void Display::init() {
    if (_dspl.isrun())
        _dspl->init();
}

void Display::redraw() {
    if (_dspl.isrun())
        _dspl->draw();
}

Display::Display(hnd_t hnd, bool clr, bool visible) :
    hnd(hnd),
    clr(clr)
{
    if (!visible)
        return;
    if (!_dspl.isrun())
        _dspl = wrkRun<_dsplWrk>();
    _dspl->add(this);
}

Display::~Display() {
    hide();
}

void Display::show() {
    if (!_dspl.isrun())
        _dspl = wrkRun<_dsplWrk>();
    _dspl->del(this);
    _dspl->add(this);
}

void Display::hide() {
    if (!_dspl.isrun())
        return;
    _dspl->del(this);
    if (_dspl->empty())
        _dspl.term();
}
