cliffanet/rwled/(commit log)

2023-10-21 design - каркас приложения для создания сцен
2023-10-21 design - воспроизведение и список элементов
2023-10-22 design - добавление/удаление элементов сделано через меню
2023-10-22 design - подтверждение удаления элементов
2023-10-23 design - отрисовка участника и перетаскивание
2023-10-23 design - курсор для перетаскивания
2023-10-31 hw led20
    [ledpanel-al20.kicad_pcb, ledpanel-al20.kicad_sch]
2023-10-31 hw led20 - поправлены зоны питания
    [ledpanel-al20.kicad_pcb]
2023-10-31 hw ctrl - схема (не проверена)
    [rwled-ctrl.kicad_pcb, rwled-ctrl.kicad_sch]
2023-11-04 hw ctrl - плата - расставлены элементы
    [rwled-ctrl.kicad_pcb, rwled-ctrl.kicad_sch]
2023-11-04 hw ctrl - плата доразведена
    [rwled-ctrl.kicad_pcb, rwled-ctrl.kicad_sch]
2023-11-05 hw led20 - перечерчен гербер
    [rwled-ctrl.kicad_pcb]
2023-11-05 hw - сделаны led15 и led10
    [ledpanel-al10.kicad_pcb, ledpanel-al10.kicad_sch, ledpanel-al15.kicad_pcb, ledpanel-al15.kicad_sch]
2023-11-25 hw - v0.1-archive
    [ledpanel-al10.kicad_pcb, ledpanel-al10.kicad_sch, ledpanel-al15.kicad_pcb, ledpanel-al15.kicad_sch, ledpanel-al20.kicad_pcb, ledpanel-al20.kicad_sch, rwled-ctrl.kicad_pcb, rwled-ctrl.kicad_sch]
2023-11-25 rwdesign - загрузка json - объекты
2023-11-26 rwdesign - загрузка json - движение
2023-11-27 rwdesign - доработки движения
2023-11-27 rwdesign - вращение
2023-12-02 rwdesign - инклюд из другого файла и отрисовка номера
2023-12-02 rwdesign - отрисовка расположения светодиодов
2023-12-02 rwdesign - свет - базовая отрисовка
2023-12-03 rwdesign - свет - sector
2023-12-03 rwdesign - при загрузке нового файла - выставлять ему tm
2023-12-03 rwdesign - свет - параметр ожидания после завершения анимации
2023-12-03 rwdesign - примеры
2023-12-03 rwdesign - получение нужного цвета для светодиодов
2023-12-05 rwdesign - точечное рисование света на основе получения цвета в каждой точке
2023-12-10 rwdesign - зацикливание
2023-12-10 rwdesign - сохранение персональных led-файлов
2023-12-16 rwdesign - led-файлы - изменён формат, теперь каждый диод построчно
2023-12-16 fw - общий каркас и парсер из консоли (теряет буфер, нужен другой канал)
2023-12-16 wifi + парсер через веб-аплоад
2023-12-17 доработки парсинга
2023-12-17 сохранение потока во временный файл и завершение wifi-upload-сессии
2023-12-17 проигрывание сценария на светодиодах, пока без зацикливания
2023-12-23 зацикливание воспроизведения
2023-12-23 опциональное форматирование при аплоаде
2023-12-23 обработчик кнопки
2023-12-23 индикация светодиодами
2023-12-26 корпус
    [rwled-down.stl, rwled-up.stl, rwled.FCStd]
2023-12-26 работа с файлами - напрямую в esp-idf
2023-12-28 переделано управление кнопкой и индикацией + имя wifi содержит my-num
2023-12-29 включение/выключение
2023-12-30 корпус - доработки
    [rwled-down.stl, rwled-up.stl, rwled.FCStd]
2024-01-01 плата - добавлен "*" для bmp280
    [rwled-ctrl.kicad_pcb]
2024-01-02 подключён высотомер
2024-01-03 реструктуризация модулей
2024-01-03 каркас wifidirect - прямого общения по wifi
2024-01-04 бинарная упаковка данных в пакеты
2024-01-04 синхронизация на тестовых светодиодах для отладки
2024-01-13 корпус - правка диаметра отверстий верхней части
    [rwled-up.stl, rwled.FCStd]
2024-01-13 обновлённая версия altcalc
2024-01-13 переработан алгоритм синхронизации и старта сценария
2024-01-14 режим таймера - так же синхронизировать
2024-01-14 доработки режима canopy
2024-01-14 доработка индикации вкл/выкл питания
2024-01-15 рефакторинг ledstream - вынесены: инициализация файловой системы, парсер/сохранятор из текстового потока во временный файл
2024-01-16 рефакторинг ledstream - вынесены: управление светодиодными лентами (вкл всей ленты в определённый цвет) и заготовка под чтение сценария
2024-01-17 рефакторинг ledstream - вынесен сценарий
2024-01-18 доработки по режимам подсветки лент
2024-01-28 баги по воспроизведению сценария
2024-02-04 мьютексы - попытка решить случайные зависания при остановке сценария
2024-02-06 поправлены световые режимы
2024-02-06 тест
2024-02-18 hw - доработки платы под oled-дисплей
    [rwled-ctrl.kicad_pcb, rwled-ctrl.kicad_sch]
2024-02-18 hw - подвинуты отверстия din/dout на светодиодных лентах
    [ledpanel-al10.kicad_pcb, ledpanel-al15.kicad_pcb, ledpanel-al20.kicad_pcb]
2024-02-18 Рассчёт сегментов светодиодных лент
2024-02-19 hw - архив доработанных и отправленных в заказ плат
    [ledpanel-al10.kicad_pcb, ledpanel-al10.kicad_sch, ledpanel-al15.kicad_pcb, ledpanel-al15.kicad_sch, ledpanel-al20.kicad_pcb, ledpanel-al20.kicad_sch, rwled-ctrl.kicad_pcb, rwled-ctrl.kicad_sch]
2024-02-26 box - архив v0.1
    [rwled-down.stl, rwled-up.stl, rwled.FCStd]
2024-03-09 rwdesign - доработки по загрузке файлов
2024-03-09 переименование файлов в примерах
2024-03-11 буфер чтения сценария переделан под догрузку отдельным потоком. Осталось делать seek
2024-03-12 буфер чтения сценария - доработан loop/seek
2024-03-13 блок заполнения данных о цветах светодиодов в массивах (подготовка к своему управлению светодиодами)
2024-03-14 своя отправка команд на светодиоды, но нужно ещё отладить зависания show-потока.
2024-03-15 ledlight - воркер формирования массивов цветов светодиодов (будем сюда так же выносить всю работу с самими лентами)
2024-03-16 допереработан блок отображения сценария - перевели всё на воркеры, а чтение из файла в буфер осталось отдельным потоком
2024-03-16 доработки по синхронизации (нужно отлаживать)
2024-03-16 display - высотомер и mynum
2024-03-17 display - режим светодиодного сценария, вкл/выкл питания
2024-03-17 display - состояние wifiserver
2024-03-17 worker interval = 30ms - вернули обратно с небольшими доработками (пропуски перерисовки дисплея и более медленная отправка сигналов на светодиодные ленты)
2024-03-18 поправлены баги altcalc / ringsimple
2024-03-18 altcalc - обновление
2024-04-01 hwver (есть пересечения пинов в разных версиях)
2024-04-06 индикатор заряда батарей + баг перезагрузки при отсутствии сценария
2024-04-20 доработки altcalc
2024-06-04 доработки инициализации дисплея
2024-06-04 корпус под дисплей
    [rwled-up.stl, rwled.FCStd]
2024-06-04 корпус зарядника
    [charger-down.stl, charger-up.stl]
2024-09-29 тестирование светодиодов при включении
    [rwled-down.stl, rwled.FCStd]
2024-10-18 описание параметров лент
2024-11-12 данные по креплению приборов
